Makerspace-Amiens-2025-26/Puzzle-Bot-Groupe05/README.md

# Puzzle bot groupe 5

## Bienvenue sur Notre Projet

Ce repository est le cœur de notre projet. Ici, vous trouverez toutes les ressources nécessaires pour comprendre, utiliser et contribuer à notre projet.

### Contenu du Repository

- **Documentation :** Toutes les documentations techniques et guides d'utilisation sont disponibles dans le dossier `docs`. Voir le site de doc associé. 
- **project :** Toutes les sources de notre projet.

### Comment Utiliser ce Repository ?

- Pour commencer, consultez la documentation dans le dossier `docs`.
- Si vous souhaitez contribuer au projet, veuillez lire nos directives de contribution.

## Contribution

Nous accueillons et apprécions toute contribution. Si vous souhaitez contribuer, veuillez consulter notre guide de contribution pour connaître nos attentes et notre processus.

## Contact

Si vous avez des questions ou des suggestions, n'hésitez pas à nous contacter.
