Makerspace-Amiens-2025-26/Puzzle-Bot-Groupe05/docs/materiel.md

---
layout: default
title: Liste des Matériaux
nav_order: 4
---

# Liste des Matériaux

- plateau
 
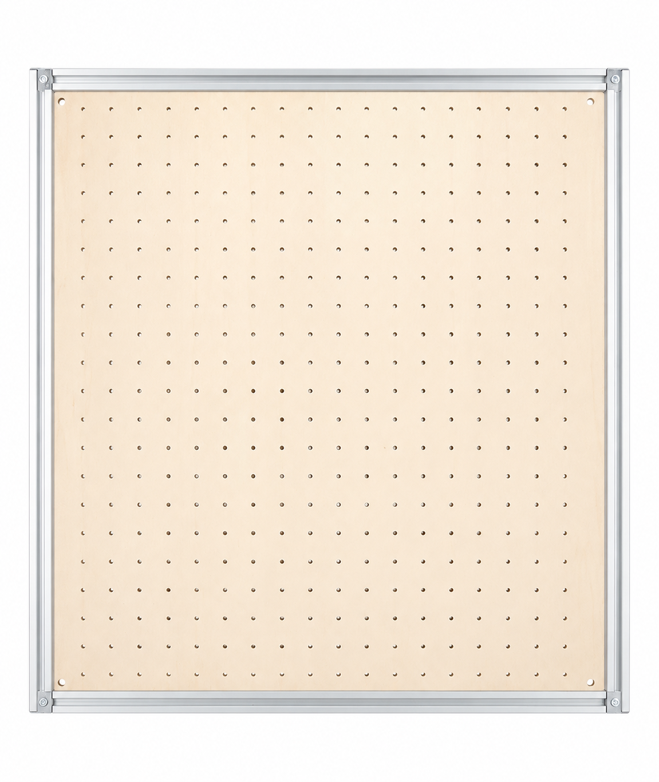
[picture p1: docs/images/Plateau.png]
  
- profilés
  
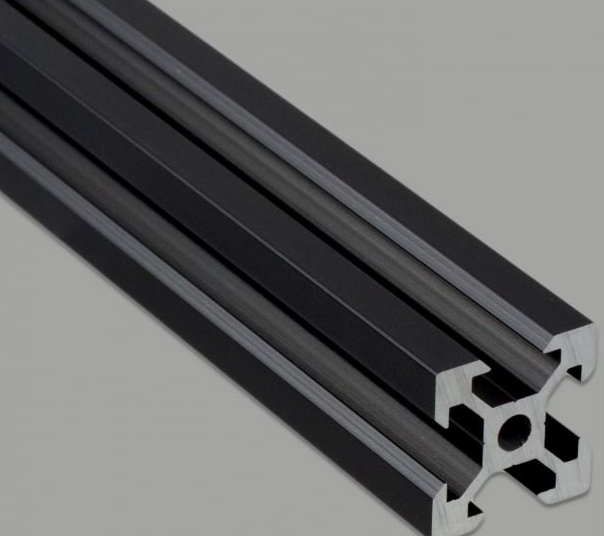
[picture p2: docs/images/profile.PNG]
  
- carte Arduino Uno
  
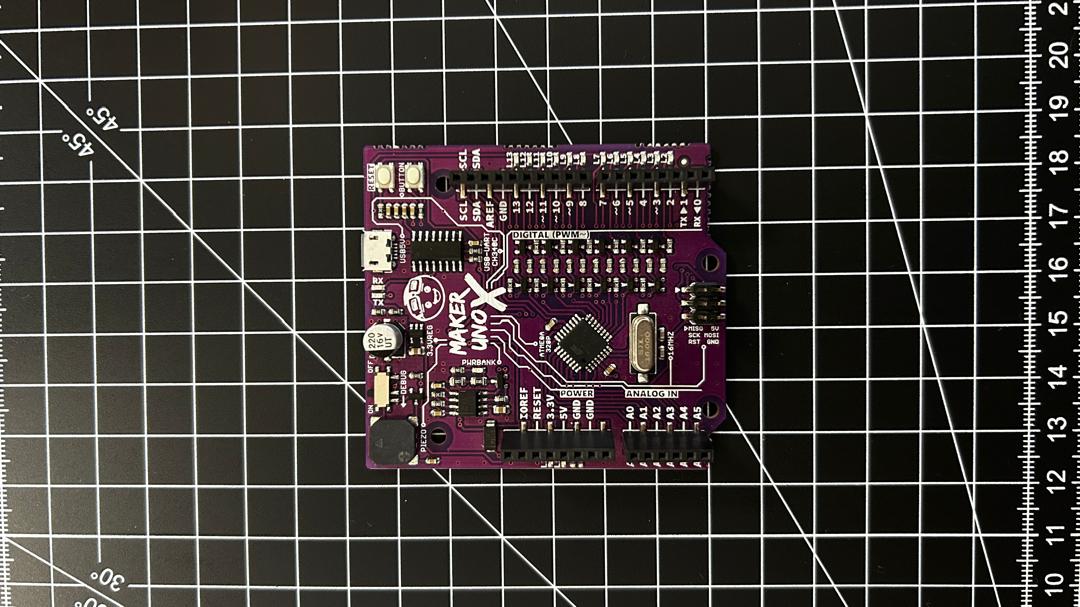
[picture p3: docs/images/Carte Uno.jpeg]
  
- Shield CNC

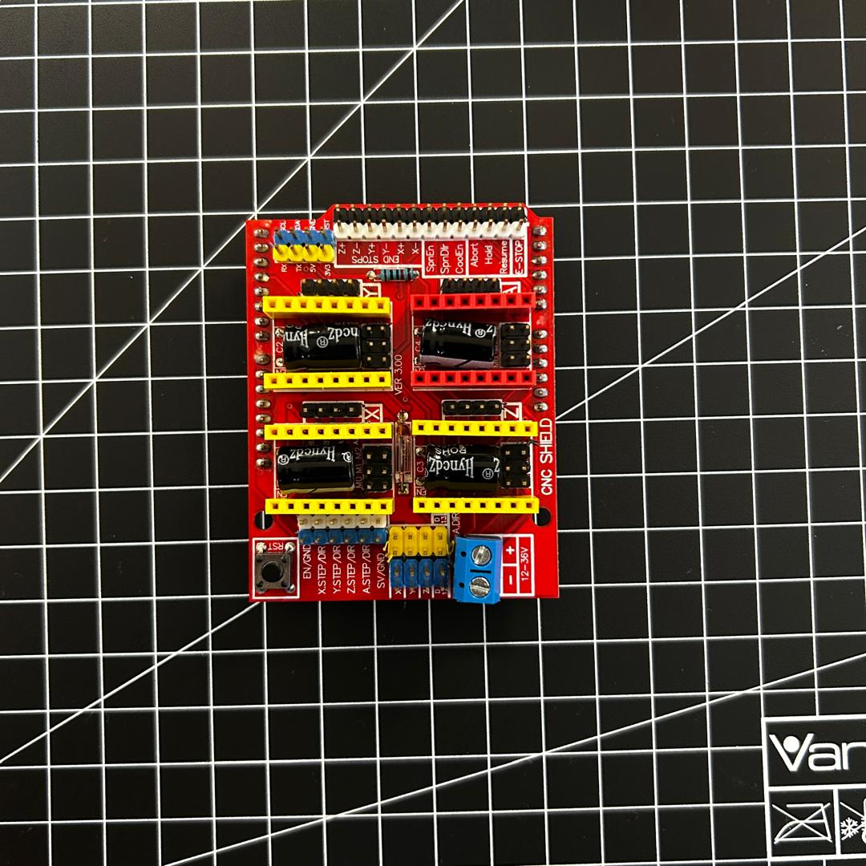
[picture p4: docs/images/CNC shield.jpeg]
  
- servomoteur

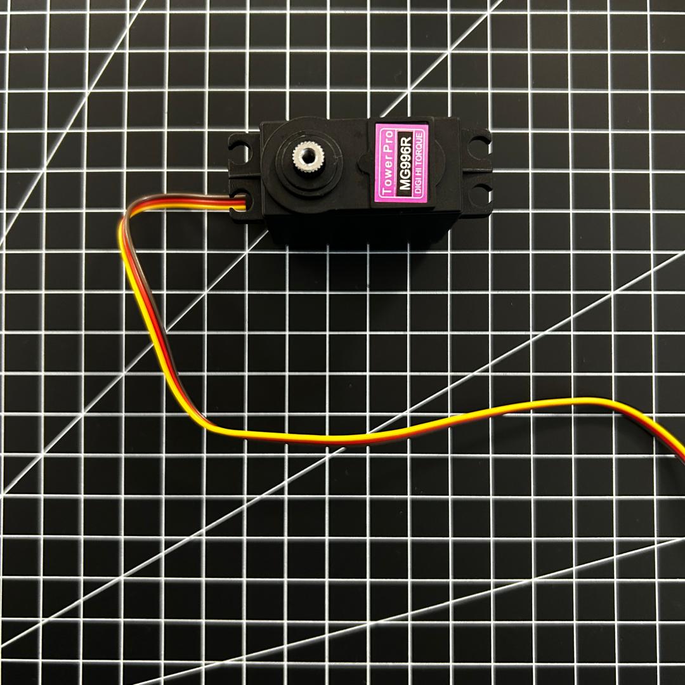
[picture p5: docs/images/Servomoteur.jpeg]
  
- moteurs pas-à-pas ([lien](https://www.omc-stepperonline.com/fr/e-serie-nema-17-bipolaire-26ncm-36-82oz-in-1-2a-42x42x30mm-4-fils-avec-1m-de-cable-et-connecteur-17he12-1204s))

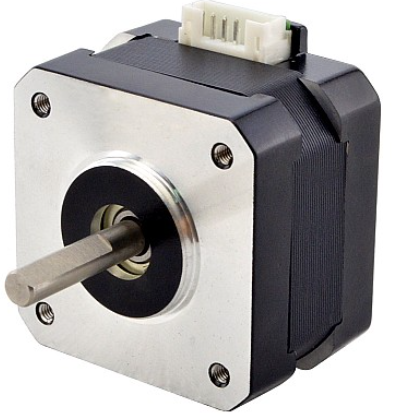
[picture p6: docs/images/stepper.PNG]
  

- Caméra fit0892 ([lien](https://www.gotronic.fr/art-camera-720p-usb-fit0892-35136.htm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))

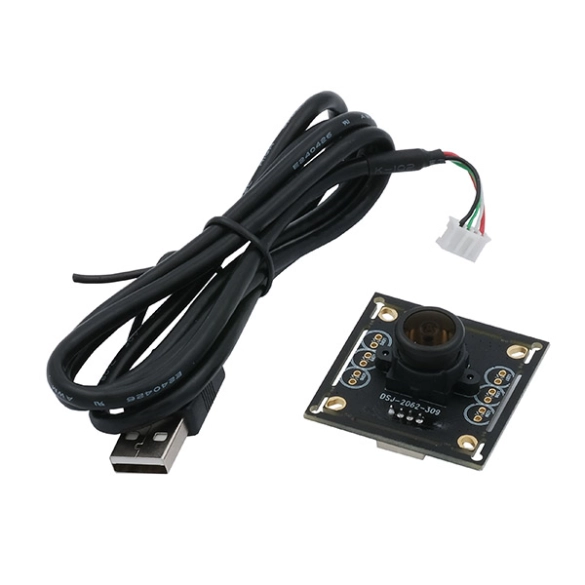
[picture p7: docs/images/camera.webp]
  
  
- driver pour les moteurs pas-à-pas (A4988)

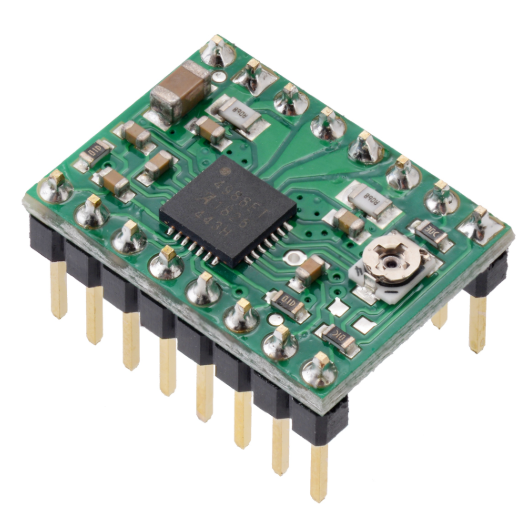
[picture p8: docs/images/Driver.PNG]
  
- MOSFET

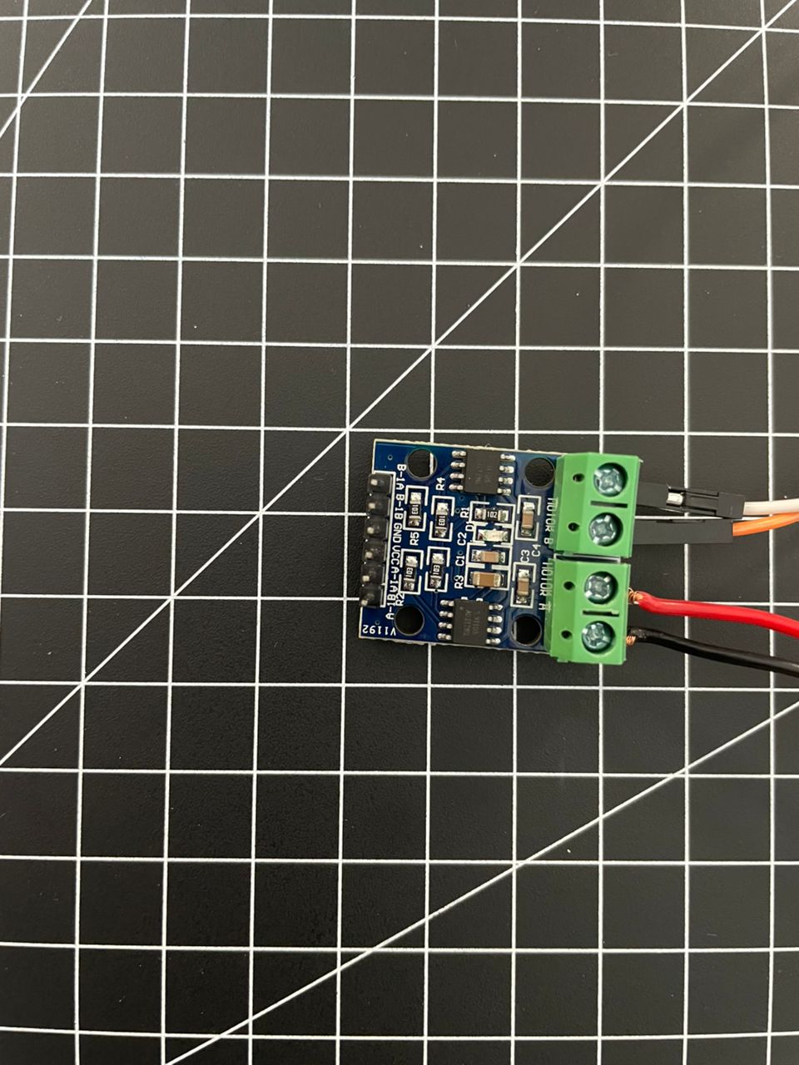
[picture p9: docs/images/Mosfet.jpeg]
  
- kit préhenseur pneumatique (pompe + electrovanne ([lien](https://www.robot-maker.com/shop/moteurs-et-actionneurs/605-kit-prehenseur-pneumatique-605.html)))

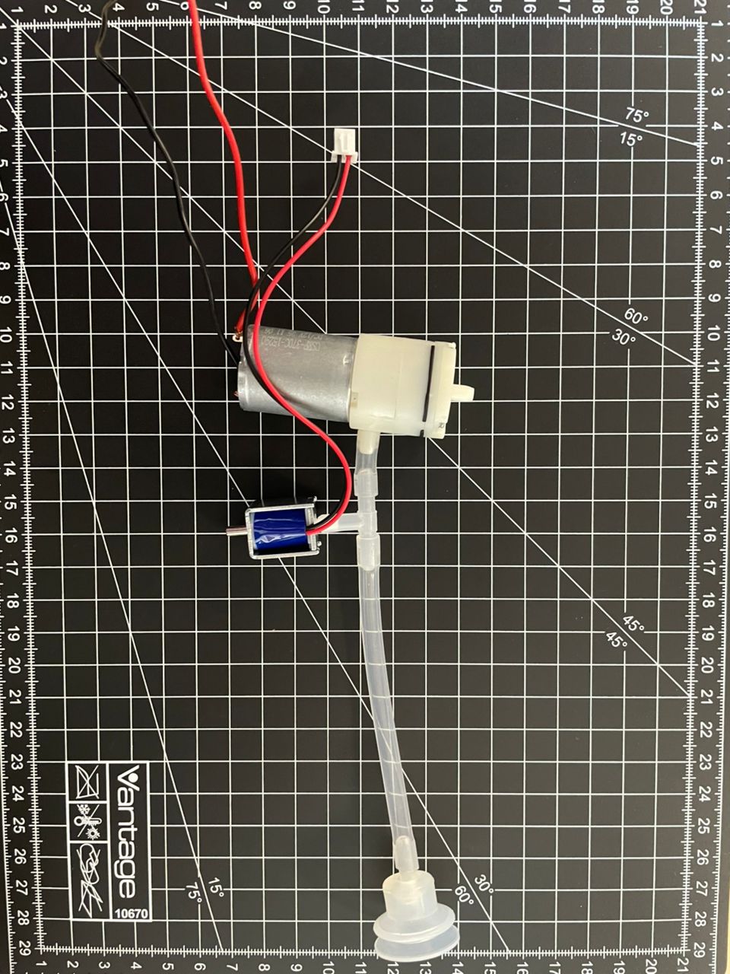
[picture p10: docs/images/Ventouse.jpeg]
  
- interrupteurs fin de course

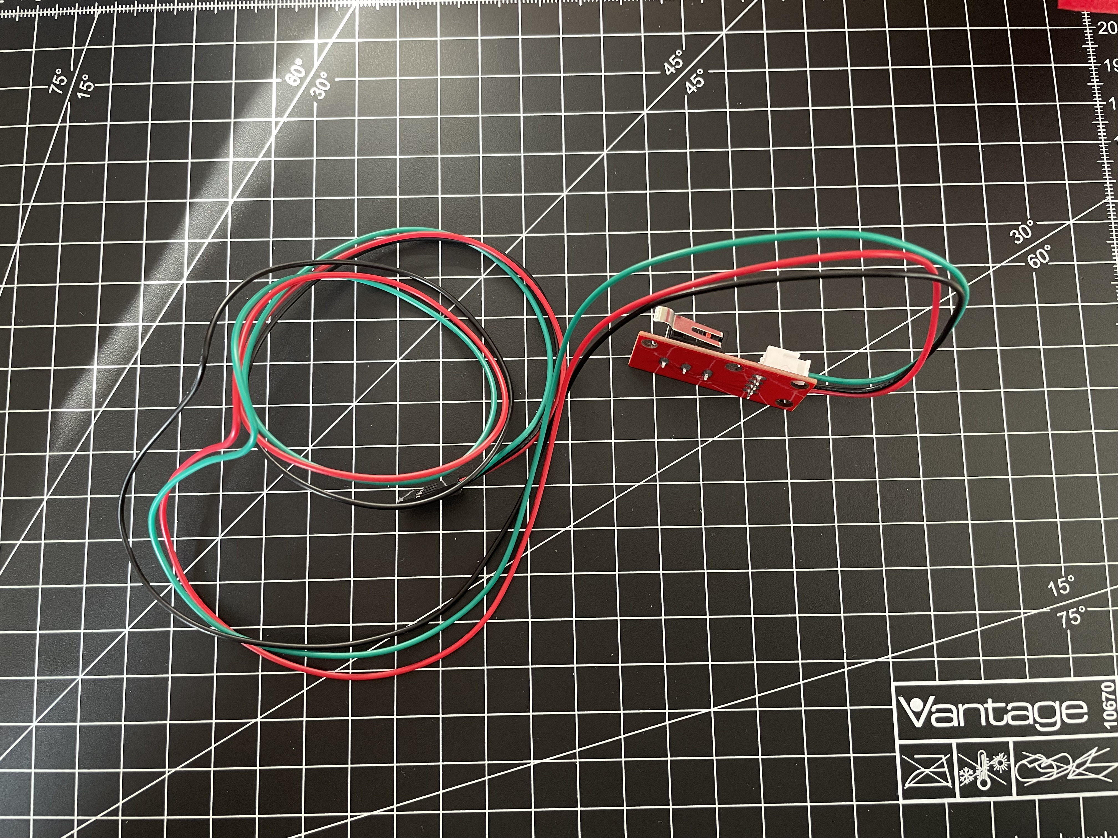
[picture p11: docs/images/fin_de_course.jpeg]
  
- interrupteurs d'urgence

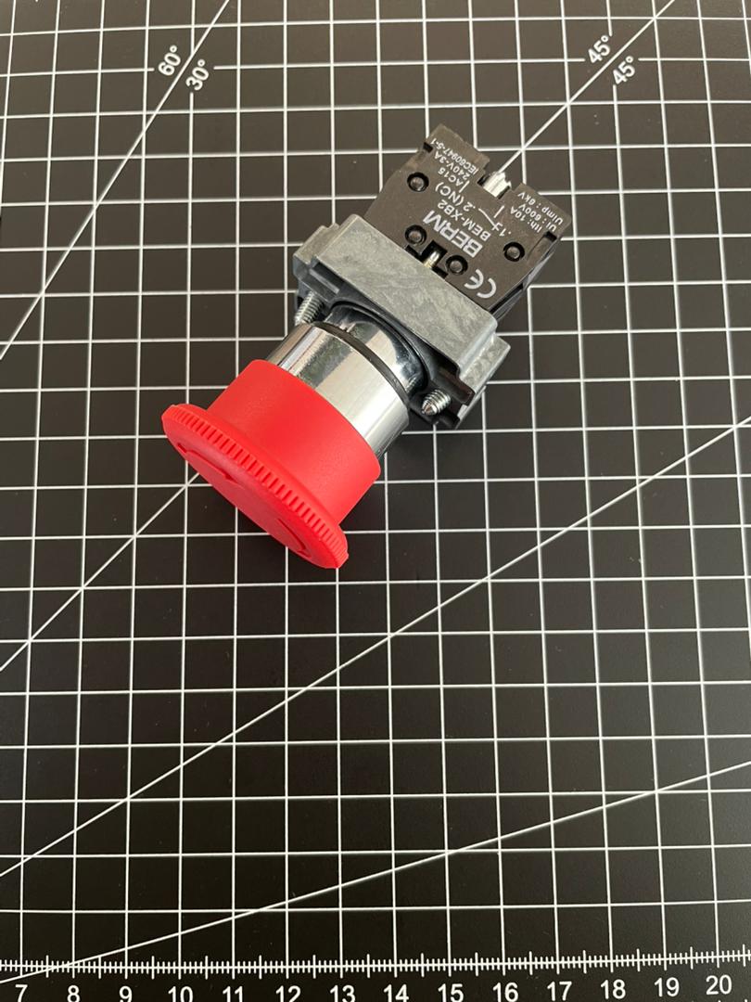
[picture p12: docs/images/Bouton d'arret d'urgence.jpeg]
  
  
- imprimantes 3d pour fabriquer des socles pour les autres matériaux
  
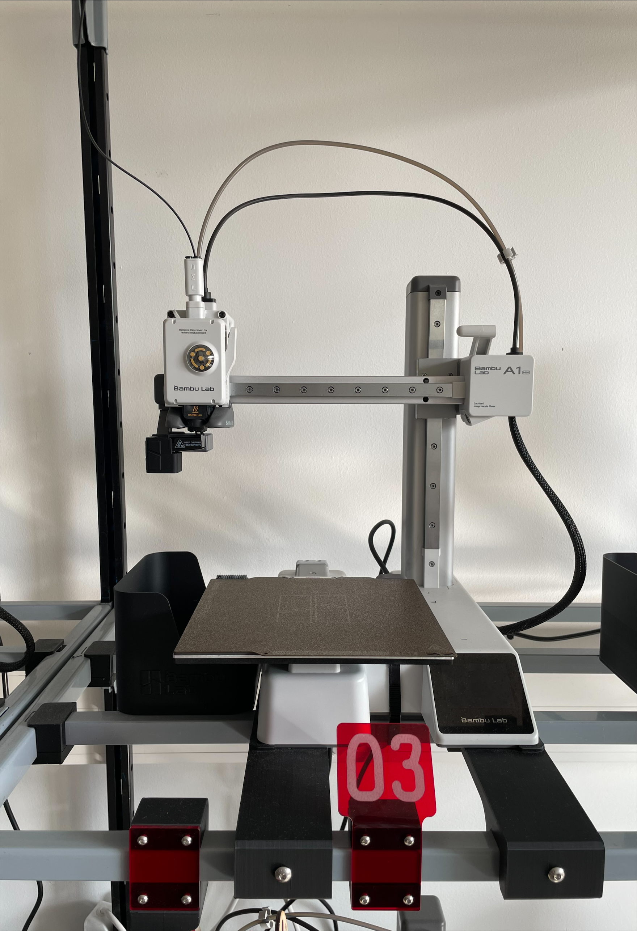
[picture p13: docs/images/Imprimante_3D.jpeg]
  

- pièces de puzzles avec marqueurs ArUco

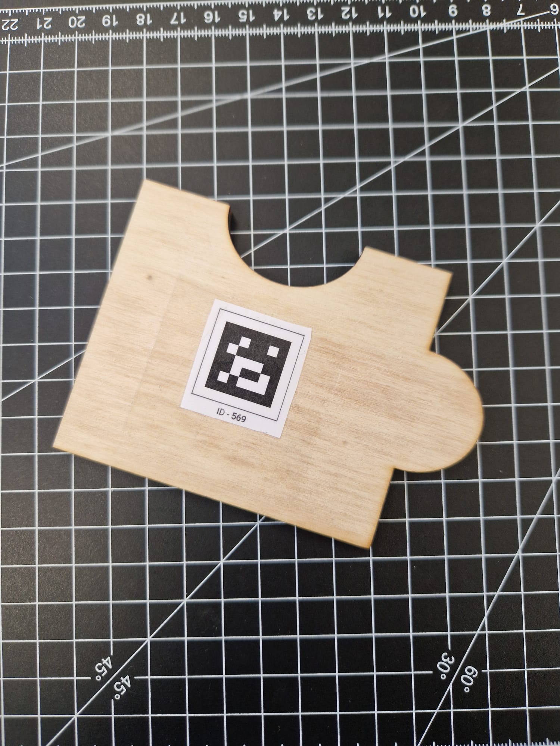
[picture p14: docs/images/piece.jpeg]
  

- courroies
  
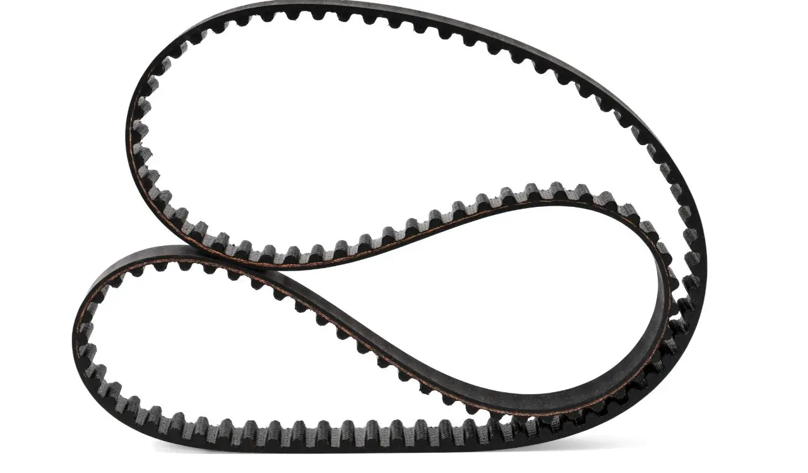
[picture p15: docs/images/courroie.webp]
 
- Fils électriques 

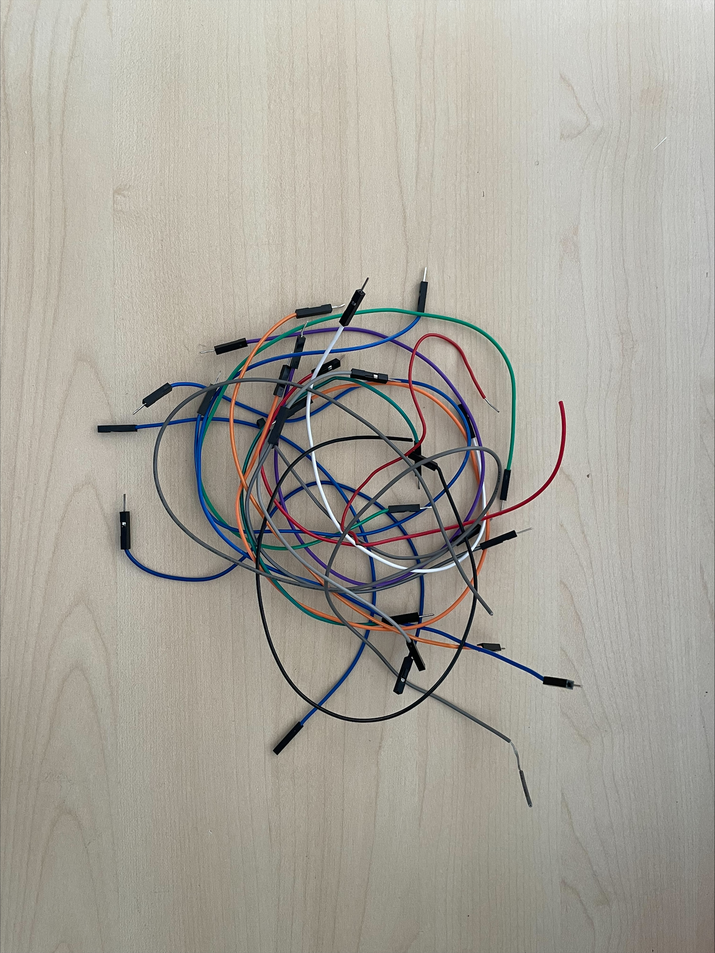
[picture p16: docs/images/Fils_électrique.jpeg]
 

- outils divers (pinces, tournevis, ...)
  
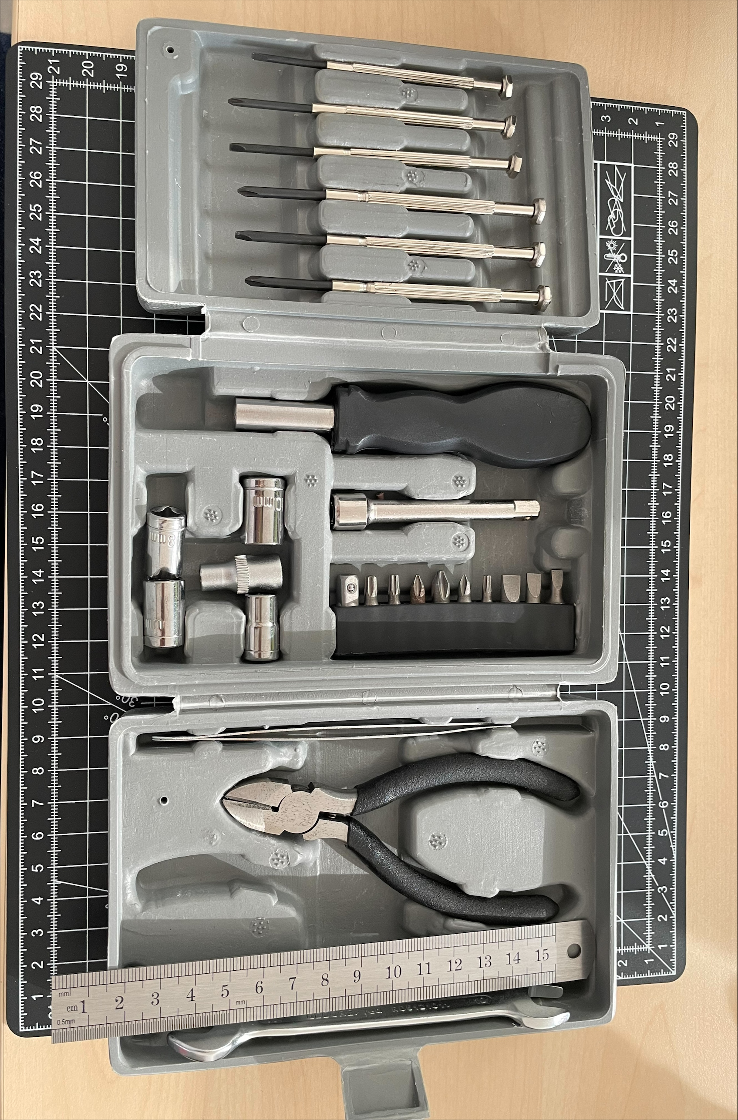
[picture p17: docs/images/Tournevis.jpeg]
 
 
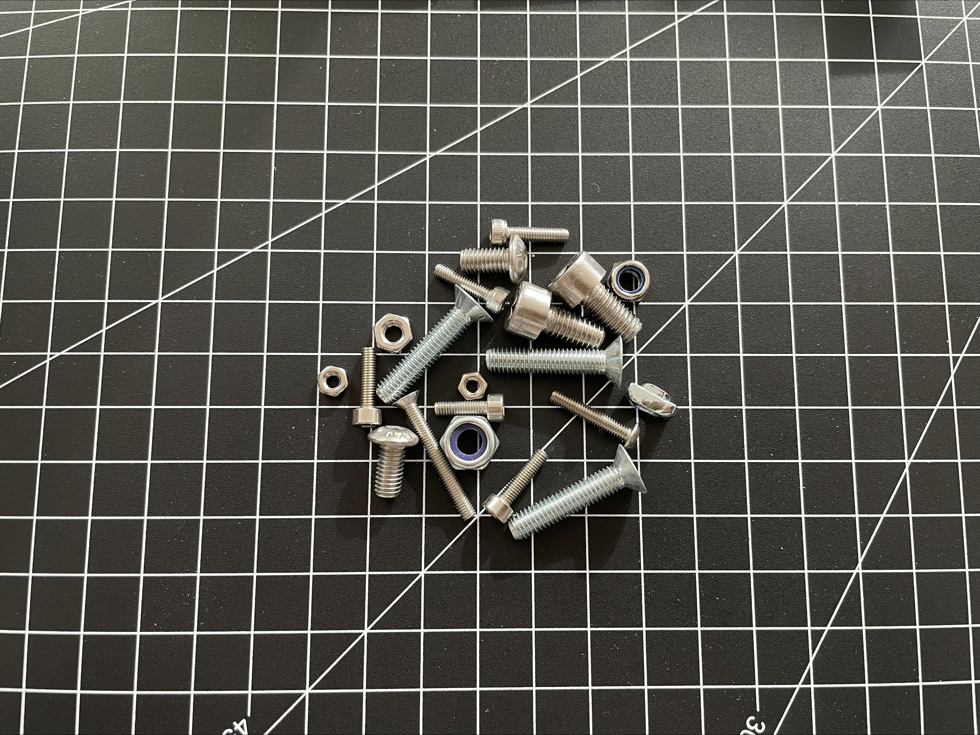
[picture p18: docs/images/Vis_et_écrous.jpeg]
