Makerspace-Amiens-2025-26/Puzzle-Bot-Groupe05/docs/equipe/equipe.md

---
layout: default
nav_order: 3
title: Notre équipe
has_children: true
---

# Notre équipe

Dans cette section vous trouverez les détails sur les membres de notre équipe organisée par pôles de compétences.

## Organisation 

__Binôme 1 : Conception__

Membres: *LOUIS & ENRIC*
  
Ce binôme est responsable de la partie physique de la machine. Leur objectif est de s'assurer que la machine soit stable et capable de manipuler les pièces du puzzle sans les abimer. Pour ce faire, ils utilisent le logiciel OnShape pour dessiner toutes les pièces et les assembler virtuellement de manière à visualiser une version de notre machine. Grâce à cela, ils peuvent faire une impression 3D ou une découpe laser des pièces pour ensuite l'ajouter à la partie physique de notre machine.

__Trinôme : Electronique__ 

Membres: *JEANNY , CARLA-SERENA , ARIANE*

Ce trinôme s'occupe de faire le lien entre l'ordinateur et les mouvements du robot. Concrètement, ils préparent la carte électronique pour faire fonctionner les moteurs avec précision et installe un composant (le MOSFET) pour que l'Arduino puisse allumer la pompe de la ventouse. Il assure aussi la sécurité du projet en installant le bouton d'arrêt d'urgence et veille à ce que la caméra reste allumée afin de voir les pièces du puzzle.

__Binôme 2 : Programmation__ 

Membres: *SHAZA & AYMERIC*

Ce binôme développe l'intelligence du robot en combinant la vision par ordinateur et le contrôle des mouvements. Ils se chargent de coder les instructions envoyées à l'Arduino pour coordonner précisément l'activation de la ventouse et le déplacement des moteurs, permettant ainsi au robot d'assembler le puzzle de manière autonome.
