Makerspace-Amiens-2025-26/Puzzle-Bot-Groupe05/project/README.md

Afin de nous renseigner sur le fonctionnement des différentes pièces du projet, nous avons effectué de multiples recherches. Vous trouverez ci-aprés une liste non exaustive de certaines ressources que nous avons utilisées. Certains liens important se trouvent directement dans la documentation et n'ont pas été reportés ici.

# Les ressources du projet :

## Détection de marqueur ArUco avec python
Explication générale: [https://pyimagesearch.com/2020/12/21/detecting-aruco-markers-with-opencv-and-python/](https://pyimagesearch.com/2020/12/21/detecting-aruco-markers-with-opencv-and-python/)

Explication OpenCV: [https://www.pythoniaformation.com/blog/tutoriels-python-par-categories/apprendre-la-computer-vision/opencv-bases-partie1](https://www.pythoniaformation.com/blog/tutoriels-python-par-categories/apprendre-la-computer-vision/opencv-bases-partie1)

Documentation OpenCV: [https://docs.opencv.org/3.4/index.html](https://docs.opencv.org/3.4/index.html)

OpenCV et marqueur ArUco: [https://towardsdev.com/aruco-marker-generation-and-detection-with-opencv-python-with-newer-updated-version-f801d7dcf211](https://towardsdev.com/aruco-marker-generation-and-detection-with-opencv-python-with-newer-updated-version-f801d7dcf211)

Explication générale par video: [https://www.youtube.com/watch?v=bS00Vs09Upw](https://www.youtube.com/watch?v=bS00Vs09Upw)

## Connaissance des pins de la carte Arduino uno

Information générale en image: https://www.bing.com/images/search?id=BF2F7054A0C84950950C7A34FA38D9A87FACA837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

## Connaissance du fonctionnement des moteurs pas à pas 
Explication générale:[ https//maxonmultitech.fr/fr_FR/nos-guides/guilde-moteur-electrique-pas-a-pas-tout-comprendre-pour-une-integration-reussie](https://maxonmultitech.fr/fr_FR/nos-guides/guilde-moteur-electrique-pas-a-pas-tout-comprendre-pour-une-integration-reussie)

Explication par vidéo: https://www.bing.com/videos/riverview/relatedvideo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 

Explication fournie par l'école : https://makerspace-amiens.fr/puzzle-bot/docs/hardware/stepper/

## Utilisation et pilotage des servomoteurs  
Information générale : https://makerspace-amiens.fr/puzzle-bot/docs/hardware/servomotor/

## Driver du moteur 
Information générale : https://makerspace-amiens.fr/puzzle-bot/docs/hardware/driver/

## Fonctionnement du kit préhenseur pneumatique 
Information générale : https://www.robot-maker.com/shop/moteurs-et-actionneurs/605-kit-prehenseur-pneumatique-605.html

## Documentation du CNC Shield 
Information générale : https://makerspace-amiens.fr/puzzle-bot/docs/hardware/cnc-shield/

https://www.youtube.com/watch?v=fyH5hU6ctvw&start=492
