Makerspace-Amiens-2025-26/Puzzle-Bot-Groupe05/docs/travail/travail.md

---
layout: default
nav_order: 2
title: Notre travail
has_children: true
---
Dans cette section vous trouverez des explications sur les différentes parties du projet ainsi que nos réalisations répartis par en fonction des sous-groupes. 

Vous pouvez retrouver certains liens que nous avons pu utiliser tout au long de notre projet dans le fichier read_me.md de la partie projet de notre repository ou tout au long de la lecture des documents.
