Makerspace-Amiens-2025-26/Puzzle-Bot-Groupe05/docs/premiers-pas/premiers-pas.md

---
layout: default
title: Premiers pas sur le template
nav_order: 7
has_children: true
---
# Introduction aux Sites Jekyll

Ce document vise à expliquer ce qu'est un site Jekyll et comment il est utilisé dans ce repository pour la documentation et la gestion de votre projet.

## Qu'est-ce que Jekyll ?

Jekyll est un générateur de sites statiques simple, blog-aware, utilisé pour créer un site web ou un blog à partir de texte brut. Il est particulièrement bien adapté pour créer des sites de documentation de projets.

### Caractéristiques Principales

- **Simplicité :** Pas de bases de données, pas de serveurs complexes. Jekyll fonctionne avec des fichiers texte.
- **Blog-Aware :** Prise en charge intégrée pour les blogs, y compris les posts, les pages, les tags, etc.
- **Personnalisable :** Thèmes modulables et système de plugins pour étendre les fonctionnalités.
- **Markdown :** Utilise la syntaxe Markdown pour le contenu, ce qui facilite la rédaction et la mise en page.

## Utilisation de Jekyll dans ce Repository

Dans ce repository, Jekyll est utilisé pour créer et gérer la documentation de votre projet. 

### Documentation et Projet

- **Documentation :** Toute la documentation de votre projet, y compris les guides, tutoriels et références, sera hébergée sur le site Jekyll.
- **Sources du Projet :** En plus de la documentation, les sources de votre projet seront disponibles ici, permettant aux autres de découvrir, de reproduire ou de s'inspirer de votre travail.

### Premiers Pas avec Jekyll

Dans la section `docs` de ce repository, vous trouverez des informations et des guides sur la façon de modifier et de créer de nouveaux contenus pour votre documentation Jekyll. Que vous soyez un contributeur expérimenté ou un débutant, ces ressources vous aideront à prendre en main la gestion de votre site Jekyll.
