Makerspace-Amiens-2025-26/Puzzle-Bot-Groupe05/docs/images/Image.PNG

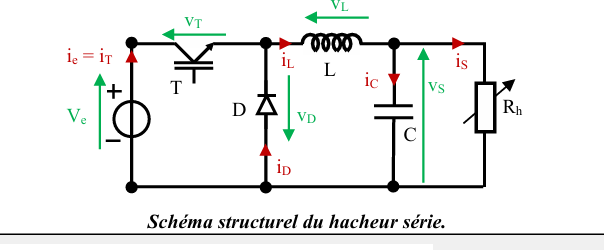
docs/images/Image.PNG
