Makerspace-Amiens-2025-26/Puzzle-Bot-Groupe05/project/main.ino

#include "AccelStepper.h"
#include "Servo.h"

// Define stepper motor connections and interface type
#define DIR_PIN_X   5
#define STEP_PIN_X  2
#define DIR_PIN_Y   6
#define STEP_PIN_Y  3
#define ENA_PIN     8

#define SERVO_UP_DOWN_PIN   11
#define SERVO_ROTA_PIN      12

#define X_LIMIT_PIN 9
#define Y_LIMIT_PIN 10

#define ELECTRO_PIN 4 
#define PUMP_PIN    13


float maxSpeed = 15000.0;
float maxAccel = 7500.0;

float homingSpeed = 4000.0;

// Create stepper instances
AccelStepper stepperX(AccelStepper::DRIVER, STEP_PIN_X, DIR_PIN_X);
AccelStepper stepperY(AccelStepper::DRIVER, STEP_PIN_Y, DIR_PIN_Y);

Servo servo_up_down;
Servo servo_rota;

// Function prototypes
void enableMotors();
void disableMotors();
void enablePump();
void disablePump();
void goUp();
void goDown();
void setSpeedAccel(float speed, float accel);
bool XlimitIsPressed();
bool YlimitIsPressed();
void runSteppers();
void homing();
void moveTo(long X_coord, long Y_coord);
void gotoX(long X_coord);

void setup() {
  Serial.begin(9600);
  servo_up_down.attach(SERVO_UP_DOWN_PIN);
  servo_rota.attach(SERVO_ROTA_PIN);
  pinMode(ENA_PIN, OUTPUT);
  pinMode(PUMP_PIN, OUTPUT);
  disablePump();
  pinMode(X_LIMIT_PIN, INPUT_PULLUP);
  pinMode(Y_LIMIT_PIN, INPUT_PULLUP);
  pinMode(ELECTRO_PIN, OUTPUT);
  digitalWrite(ELECTRO_PIN, LOW);
  delay(1000);

  disableMotors();
  Serial.println("Puzzle Bot");
  goUp();
  setSpeedAccel(maxSpeed, maxAccel);
  homing();
}

void loop() {
  pickPiece();
  servo_rota.write(45);
  moveTo(10000, 4000);
  releasePiece();
  delay(3000);
  pickPiece();
  servo_rota.write(0);
  moveTo(14000, 7000);
  releasePiece();
  delay(3000);
}

//------------------- Functions --------------------

void enableMotors(){
  digitalWrite(ENA_PIN, LOW);
  Serial.println("Driver Enabled");
}

void disableMotors(){
  digitalWrite(ENA_PIN, HIGH);
  Serial.println("Driver Disabled");
}

void enablePump(){
  digitalWrite(PUMP_PIN, LOW);
  Serial.println("Pump Enabled");
}

void disablePump(){
  digitalWrite(PUMP_PIN, HIGH);
  Serial.println("Pump Disabled");

}
void enableElectro()
{
    digitalWrite(ELECTRO_PIN, HIGH);
}
void disableElectro()
{
    digitalWrite(ELECTRO_PIN, LOW);
}

void goUp()
{
    servo_up_down.write(0);
    delay(400);
}

void goDown()
{
    servo_up_down.write(33);
    delay(400);
}

void pickPiece()
{
    // Start moving down
    servo_up_down.write(33);

    // Turn on vacuum immediately
    enablePump();
    enableElectro();

    // Wait for servo to reach bottom
    delay(300);

    // Give suction time to grab piece
    delay(500);

    // Lift piece
    servo_up_down.write(0);
    delay(300);

    Serial.println("PIECE PICKED");
}

void releasePiece()
{
    // Lower piece
    servo_up_down.write(33);
    delay(300);

    // Release vacuum
    disableElectro();
    disablePump();

    // Allow piece to drop
    delay(500);

    // Lift head
    servo_up_down.write(0);
    delay(300);

    Serial.println("PIECE RELEASED");
}

void setSpeedAccel(float speed, float accel){
  stepperX.setMaxSpeed(speed);
  stepperX.setAcceleration(accel);
  stepperY.setMaxSpeed(speed);
  stepperY.setAcceleration(accel);
}

bool XlimitIsPressed(){
  if(digitalRead(X_LIMIT_PIN) == LOW){
    Serial.println("X limit pressed");
    return true;
  }
  return false;
}

bool YlimitIsPressed(){
  if(digitalRead(Y_LIMIT_PIN) == LOW){
    Serial.println("Y limit pressed");
    return true;
  }
  return false;
}

void runSteppers(){
  stepperX.run();
  stepperY.run();
}

void homing(){
  Serial.println("Homing Begin");
  enableMotors();

  // Homing X
  stepperX.setSpeed(homingSpeed);  // negative speed if limit switch is at lower position
  while(!XlimitIsPressed()){
    stepperX.runSpeed();
  }
  stepperX.stop();
  stepperX.setCurrentPosition(0);
  stepperX.runToNewPosition(-15000);  // move away from switch
  Serial.println("Homing X OK");

  // Homing Y
  stepperY.setSpeed( homingSpeed);
  while(!YlimitIsPressed()){
    stepperY.runSpeed();
  }
  stepperY.stop();
  stepperY.setCurrentPosition(0);
  stepperY.runToNewPosition(-8000);
  Serial.println("Homing Y OK");

  disableMotors();
}

void moveTo(long X_coord, long Y_coord){
  enableMotors();
  stepperX.moveTo(-X_coord); // negative value because the axis is inverted
  stepperY.moveTo(-Y_coord);
  while(stepperX.distanceToGo() != 0 || stepperY.distanceToGo() != 0){
    stepperX.run();
    stepperY.run();
  }
  disableMotors();
}
