Makerspace-Amiens-2025-26/Puzzle-Bot-Groupe05/project/testreadnb.ino

const byte numChars = 32;
char receivedChars[numChars];   // an array to store the received data

boolean newData = false;

int dataNumber = 0;             // new for this version

void setup() {
    Serial.begin(115200); Serial.println();
    Serial.println("OK"); // let the python code know we are ready
}

void loop() {
    recvWithEndMarker();
    showNewNumber();
}

void recvWithEndMarker() {
    static byte ndx = 0;
    char endMarker = '\n';
    char rc;
    
    if (Serial.available() > 0) {
        rc = Serial.read();

        if (rc != endMarker) {
            receivedChars[ndx] = rc;
            ndx++;
            if (ndx >= numChars) {
                ndx = numChars - 1;
            }
        }
        else {
            receivedChars[ndx] = '\0'; // terminate the string
            ndx = 0;
            newData = true;
        }
    }
}

void showNewNumber() {
    if (newData == true) {
        dataNumber = 0;             // new for this version
        dataNumber = atoi(receivedChars);   // new for this version
        Serial.print("This just in ... ");
        Serial.println(receivedChars);
        Serial.print("Data as Number ... ");    // new for this version
        Serial.println(dataNumber + 1);     // new for this version
        newData = false;
    }
}
