Makerspace-Amiens-2025-26/Puzzle-Bot-Groupe05/(commit log)

2026-03-31 Add pump to the code
2026-03-31 Add servo
2026-04-27 Rename fin de course.jpeg to fin_de_course.jpeg
2026-04-27 Rename Branchement des moteurs pas à pas.jpeg to Branchement_des_moteurs pas à pas.jpeg
2026-05-05 Rename Branchement_des_ servomoteurs.jpeg to Branchement_des_servomoteurs.jpeg
2026-06-01 fix button on index
2026-06-03 Update index.md
    Modifications pour préparer l'ajout de la vidéo de présentation
2026-06-03 Update index.md
    ajout de la vidéo de présentation
2026-06-03 changement de direction de mouvement et utulisation de pump et eclectrovane
    Added electrovalve control and piece handling functions.
2026-06-05 ventouse et servo fonction ensemble
2026-06-12 Add camera and piece to materiel.md
2026-06-12 Improve conception.md up to Wheel
2026-06-12 Servo support conception.md
2026-06-12 Update stepper conception.md
2026-06-13 fix switch to image instead of link index.md
