Makerspace-Amiens-2025-26/Puzzle-Bot-Groupe05/docs/images/Branchement_des_ servomoteurs.jpeg

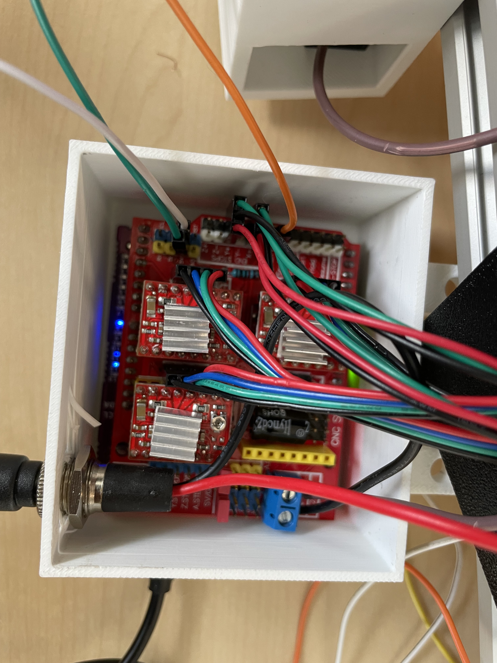
[picture p23: docs/images/Branchement_des_servomoteurs.jpeg]
docs/images/Branchement_des_ servomoteurs.jpeg
